alan05code/TermoCare/README.md

# TermoCare
Termostato domestico Smart pensato per l'efficienza, sicurezza e precisione con integrazione tramite un'applicazione web e mobile.

Progettato, sviluppato e documentato in IMET S.r.l durante il PCTO scolastico 2023.
Presentato in azienda e agli Open Day scolastici.
