alan05code/TermoCare/Hardware (Scolastico)/TermoCare.pdf

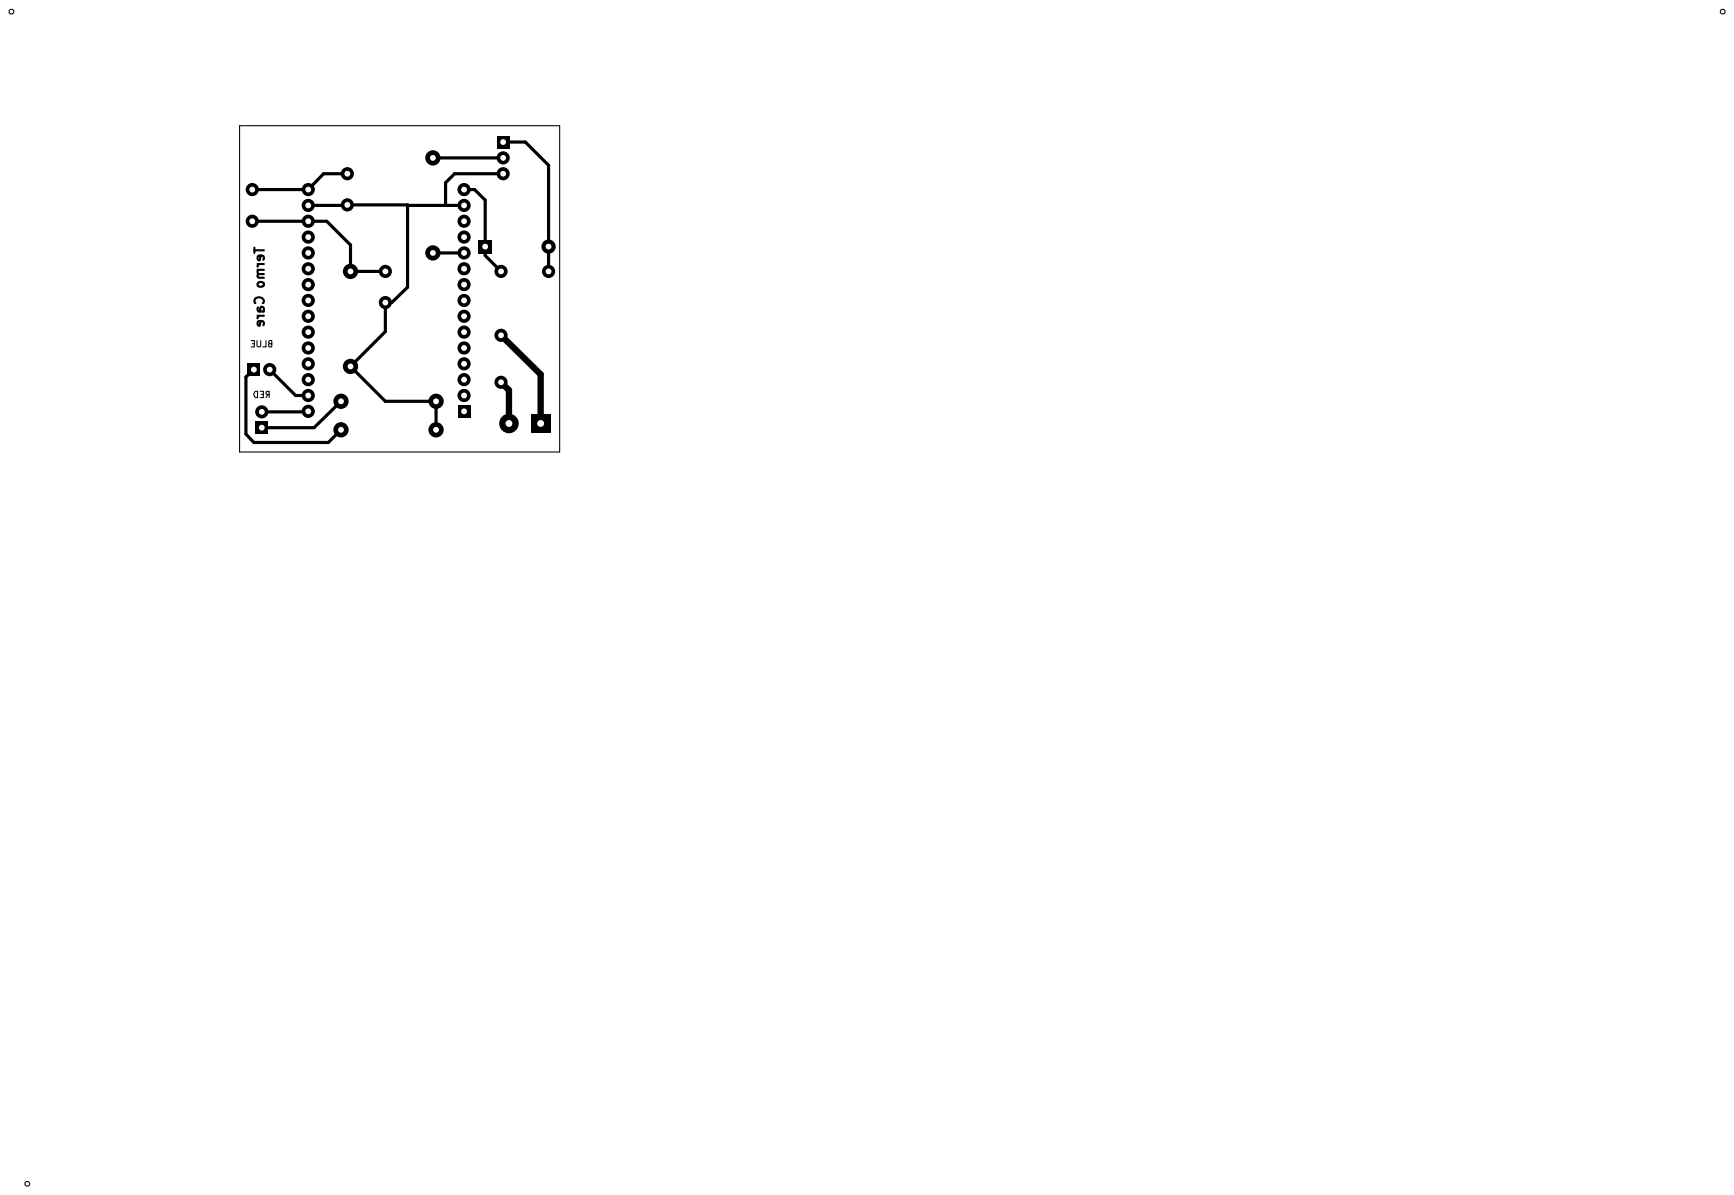
[picture p35: page 1]
