alan05code/TermoCare/(list of files, drawings)

Other design files:
Hardware (Scolastico)/esp32_OpenDay/freerouting.dsn
Hardware (Scolastico)/esp32_OpenDay/temp-freerouting.dsn
