alan05code/TermoCare/Hardware (Scolastico)/esp32_OpenDay/esp32_OpenDay.kicad_pcb

## KiCad design Hardware (Scolastico)/esp32_OpenDay/esp32_OpenDay.kicad_pcb (2025-02-07)

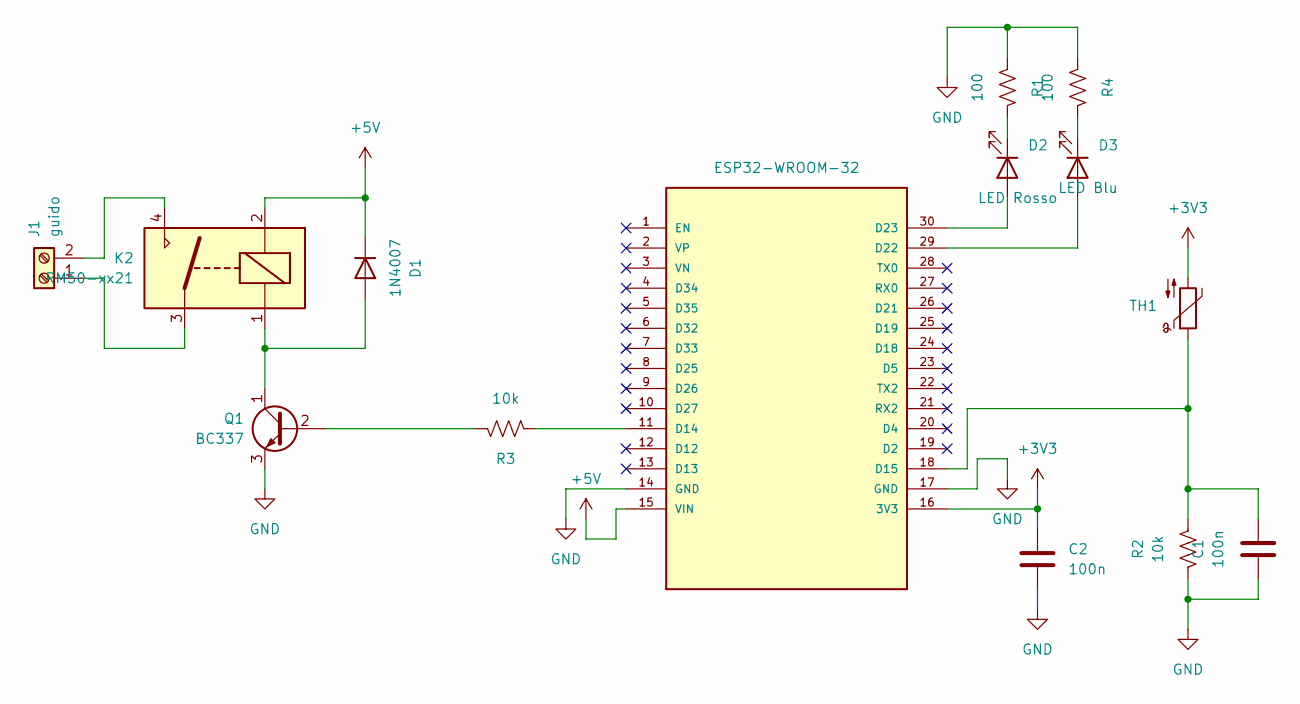
[picture p36: schematic esp32_OpenDay.kicad_sch]

Parts:
C1, C2: 100n; C_Disc_D7.0mm_W2.5mm_P5.00mm
D1: 1N4007; D_DO-41_SOD81_P10.16mm_Horizontal
D2: LED Rosso; LED_D5.0mm
D3: LED Blu; LED_D5.0mm
J1: guido; TerminalBlock_bornier-2_P5.08mm
K2: RM50-xx21; Relè_HF33F_CodiceRS_176-2640
Q1: BC337; TO-92L_Inline_Wide
R1, R4: 100; R_Axial_DIN0411_L9.9mm_D3.6mm_P15.24mm_Horizontal
R2, R3: 10k; R_Axial_DIN0411_L9.9mm_D3.6mm_P15.24mm_Horizontal
S1: ESP32-WROOM-32; MODULE_ESP32-WROOM-32; PARTREV N/A
TH1: Thermistor_NTC; R_Axial_DIN0207_L6.3mm_D2.5mm_P5.08mm_Vertical

Connections:
+3V3: C2.1, S1.16 (3V3), TH1.2
+5V: D1.1 (K), K2.2, S1.15 (VIN)
GND: C1.2, C2.2, Q1.3 (E), R1.2, R2.1, R4.2, S1.14 (GND), S1.17 (GND)
unnamed: D1.2 (A), K2.1, Q1.1 (C)
unnamed: D2.2 (A), S1.30 (D23)
unnamed: D2.1 (K), R1.1
unnamed: D3.2 (A), S1.29 (D22)
unnamed: D3.1 (K), R4.1
unnamed: J1.1, K2.3
unnamed: J1.2, K2.4
unnamed: Q1.2 (B), R3.1
unnamed: R3.2, S1.11 (D14)
unnamed: C1.1, R2.2, S1.18 (D15), TH1.1

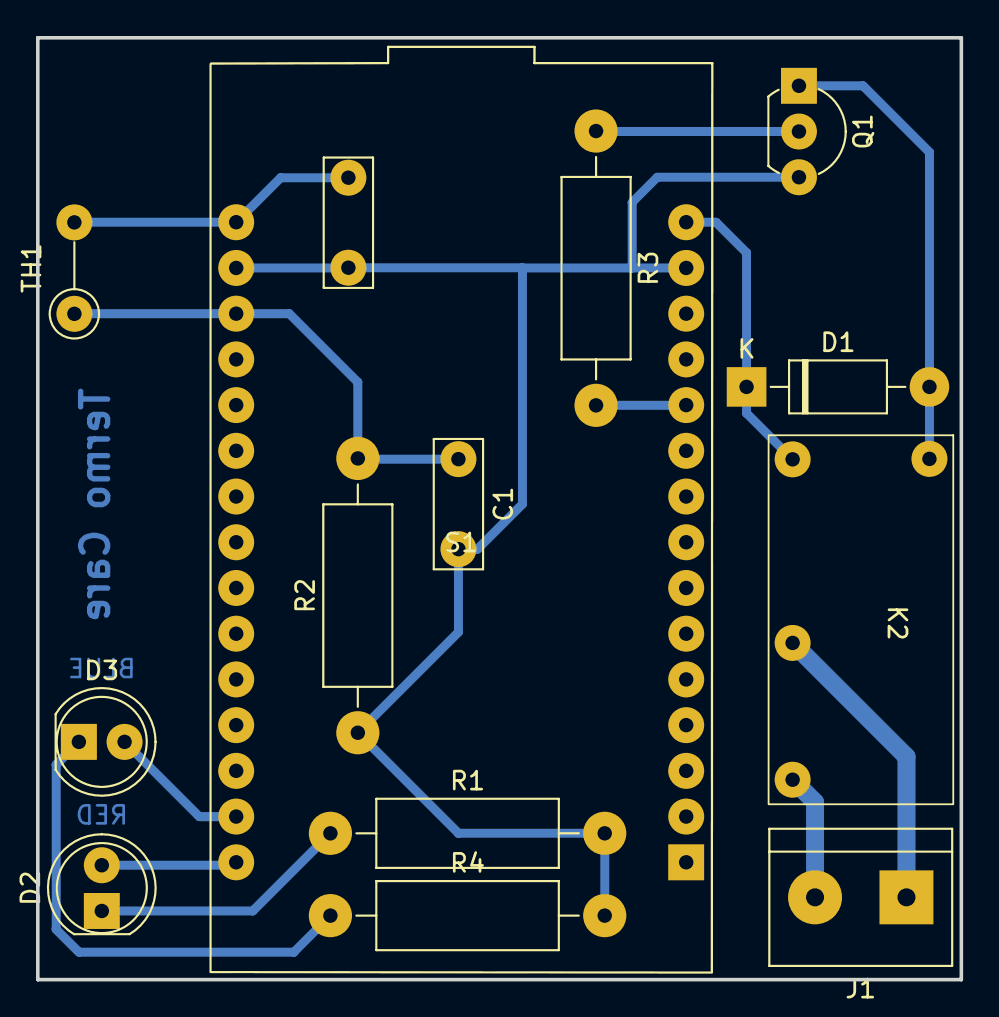
[picture p37: board esp32_OpenDay.kicad_pcb from above]

Board: 2 copper layers, 51.3 x 52.3 mm, 14 parts (0 on the bottom side), 13 nets.
