alan05code/TermoCare/esp-idf/main/app_main.c

#include "settings.h"
#include "termostato.h"
#include "interruptsConfig.h"

#include <stdio.h>
#include <stdint.h>
#include <stdlib.h>
#include <stddef.h>
#include <string.h>
#include "esp_wifi.h"
#include "esp_system.h"
#include "nvs_flash.h"
#include "esp_event.h"
#include "esp_netif.h"
#include "protocol_examples_common.h"

#include "freertos/FreeRTOS.h"
#include "freertos/task.h"
#include "freertos/semphr.h"
#include "freertos/queue.h"
#include "driver/gpio.h"
#include "driver/adc.h"
#include "esp_adc_cal.h"

#include "lwip/sockets.h"
#include "lwip/dns.h"
#include "lwip/netdb.h"

#include "esp_log.h"
#include "mqtt_client.h"

//libreria interrups
#include "driver/timer.h"

//Main
#define SEND_update 10000000        //rating invio dati
long long SEND_TEnd = 0;            //variabile aggiornamento invio dati

static const char *TAG = "MQTT_EXAMPLE";
static const char *SEND = "SENDING";

char Temperature[10];
int Count = 0;
char setPointChar[5];
float setPoint;

static void log_error_if_nonzero(const char *message, int error_code)
{
    if (error_code != 0) {
        ESP_LOGE(TAG, "Last error %s: 0x%x", message, error_code);
    }
}

static void mqtt_event_handler(void *handler_args, esp_event_base_t base, int32_t event_id, void *event_data)
{
    ESP_LOGD(TAG, "Event dispatched from event loop base=%s, event_id=%d", base, event_id);
    esp_mqtt_event_handle_t event = event_data;
    esp_mqtt_client_handle_t client = event->client;
    int msg_id;
    switch ((esp_mqtt_event_id_t)event_id) {
    case MQTT_EVENT_CONNECTED:
        ESP_LOGI(TAG, "MQTT_EVENT_CONNECTED");
        msg_id = esp_mqtt_client_publish(client, "alan_cad/feeds/temperatures", "CONNECT", 0, 1, 0);
        ESP_LOGI(TAG, "sent publish successful, msg_id=%d", msg_id);
        
        //SUBCRIBE
        msg_id = esp_mqtt_client_subscribe(client, "alan_cad/feeds/setpoints", 0);
        ESP_LOGI(TAG, "sent subscribe successful, msg_id=%d", msg_id);

        break;

    case MQTT_EVENT_DISCONNECTED:
        ESP_LOGI(TAG, "MQTT_EVENT_DISCONNECTED");
        break;

    case MQTT_EVENT_SUBSCRIBED:
        ESP_LOGI(TAG, "MQTT_EVENT_SUBSCRIBED, msg_id=%d", event->msg_id);
        msg_id = esp_mqtt_client_publish(client, "alan_cad/feeds/temperatures", "START", 0, 0, 0);
        ESP_LOGI(TAG, "sent publish successful, msg_id=%d", msg_id);
        break;
    case MQTT_EVENT_UNSUBSCRIBED:
        ESP_LOGI(TAG, "MQTT_EVENT_UNSUBSCRIBED, msg_id=%d", event->msg_id);
        break;
    case MQTT_EVENT_PUBLISHED:
        ESP_LOGI(TAG, "MQTT_EVENT_PUBLISHED, msg_id=%d", event->msg_id);
        break;
    case MQTT_EVENT_DATA:
        ESP_LOGI(TAG, "MQTT_EVENT_DATA");
        printf("TOPIC=%.*s\r\n", event->topic_len, event->topic);
        printf("DATA=%.*s\r\n", event->data_len, event->data);
        
        sprintf(setPointChar, "%.*s", event->data_len, event->data);
        setPoint = atof(setPointChar);
        printf("%.2f\n",setPoint);

        if (setPoint == 100.00) {
            ESP_LOGI(SEND, "Risposta setPoint");
            sprintf(Temperature, "%.2f", T);
            esp_mqtt_client_publish(client, "alan_cad/feeds/temperatures", Temperature, 0, 1, 0);
        } else {
            UpdateSetPoint(setPoint);
        }
        break;
    case MQTT_EVENT_ERROR:
        ESP_LOGI(TAG, "MQTT_EVENT_ERROR");
        if (event->error_handle->error_type == MQTT_ERROR_TYPE_TCP_TRANSPORT) {
            log_error_if_nonzero("reported from esp-tls", event->error_handle->esp_tls_last_esp_err);
            log_error_if_nonzero("reported from tls stack", event->error_handle->esp_tls_stack_err);
            log_error_if_nonzero("captured as transport's socket errno",  event->error_handle->esp_transport_sock_errno);
            ESP_LOGI(TAG, "Last errno string (%s)", strerror(event->error_handle->esp_transport_sock_errno));
        }
        break;
    default:
        ESP_LOGI(TAG, "Other event id:%d", event->event_id);
        break;
    }
}

static void mqtt_app_start(void)
{
    esp_mqtt_client_config_t mqtt_cfg = {
        .uri = "mqtt://io.adafruit.com",                //CONFIG_BROKER_URL
        .username = "alan_cad",
        .password = "<adafruit-password>",
    };

    esp_mqtt_client_handle_t client = esp_mqtt_client_init(&mqtt_cfg);
    /* The last argument may be used to pass data to the event handler, in this example mqtt_event_handler */
    esp_mqtt_client_register_event(client, ESP_EVENT_ANY_ID, mqtt_event_handler, NULL);
    esp_mqtt_client_start(client);

    while (true)
    {
        //ISR_Verifier();


        if(TERMINAL == ON) {
            Terminal();
        }


        if(T_TEnd < esp_timer_get_time()) {
            T_TEnd = esp_timer_get_time() + T_update;
            UpdateState();            //aggiornamento dello stato di MaS + calcolo media e conversione
        }


        if(SEND_TEnd < esp_timer_get_time()) {
            SEND_TEnd = esp_timer_get_time() + SEND_update;
            //invio dati
            ESP_LOGI(SEND, "Invio Temperatura");
            sprintf(Temperature, "%.2f", T);
            esp_mqtt_client_publish(client, "alan_cad/feeds/temperatures", Temperature, 0, 1, 0);
        }

        //TestinVita();
        vTaskDelay(1);
    }
}

void app_main(void)
{
    //ISR_Config(S_update);

    ESP_LOGI(TAG, "[APP] Startup..");
    ESP_LOGI(TAG, "[APP] Free memory: %d bytes", esp_get_free_heap_size());
    ESP_LOGI(TAG, "[APP] IDF version: %s", esp_get_idf_version());

    esp_log_level_set("*", ESP_LOG_INFO);
    esp_log_level_set("mqtt_client", ESP_LOG_VERBOSE);
    esp_log_level_set("MQTT_EXAMPLE", ESP_LOG_VERBOSE);
    esp_log_level_set("TRANSPORT_BASE", ESP_LOG_VERBOSE);
    esp_log_level_set("esp-tls", ESP_LOG_VERBOSE);
    esp_log_level_set("TRANSPORT", ESP_LOG_VERBOSE);
    esp_log_level_set("outbox", ESP_LOG_VERBOSE);

    ESP_ERROR_CHECK(nvs_flash_init());
    ESP_ERROR_CHECK(esp_netif_init());
    ESP_ERROR_CHECK(esp_event_loop_create_default());

    ESP_ERROR_CHECK(example_connect());  
    
    InitMaS();

    mqtt_app_start();
}

//PWM
